deenqtt/project-test/render_final.png

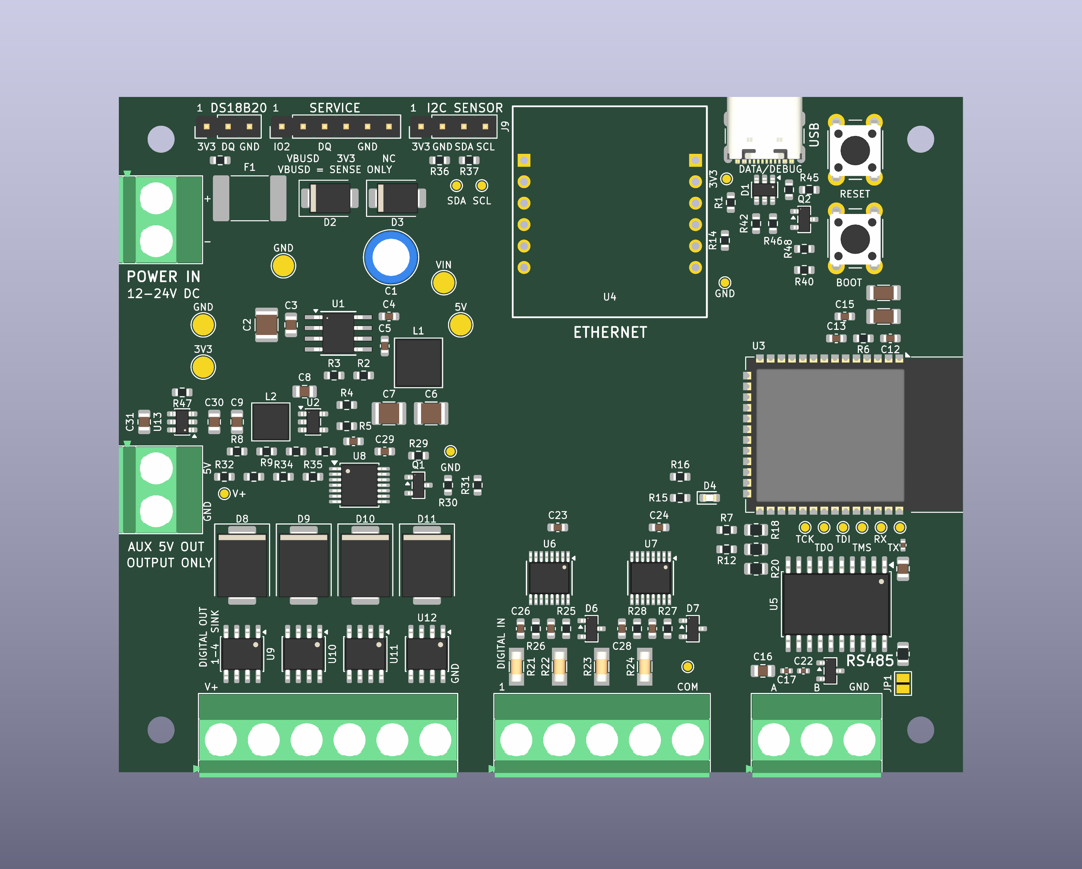
render_final.png
