deenqtt/project-test/docs/superpowers/plans/2026-09-14-phase5a-wiz850io.md

# Phase 5A WIZ850io Implementation Plan

> **For agentic workers:** REQUIRED SUB-SKILL: Use superpowers:executing-plans to implement this plan task-by-task.

**Goal:** Capture only the WIZ850io Ethernet module interface and verify its connectivity to the frozen ESP32-S3 GPIO nets.

**Architecture:** Add a dedicated hierarchical sheet using one custom 12-pin module symbol visually divided into official J1 and J2 1x6 headers. Connect it through global power and frozen Ethernet nets; retain existing MCU-side reset/select biases and add only carrier-side supply bypassing justified by the vendor module schematic.

**Tech Stack:** KiCad 9 schematic format, KiCad MCP, official WIZnet WIZ850io documentation and revision 1.1 schematic.

## Global Constraints

- Do not modify Phase 3 or Phase 4B electrical topology.
- Do not capture RS485, DI, DO, sensors, USB-C, or PCB layout.
- Do not guess module footprint geometry.
- Do not suppress ERC warnings without electrical justification.

---

### Task 1: Baseline and vendor verification

**Files:**
- Read: `hardware/kicad_mcp_test.kicad_sch`
- Read: `hardware/esp32_core.kicad_sch`

- [ ] Snapshot the project before changes.
- [ ] Verify supply range, J1/J2 pinout, SPI levels, reset timing, INT output type, and on-module bypass/damping from official WIZnet sources.
- [ ] Record any missing mechanical dimensions that prevent a production footprint.

### Task 2: Module library assets

**Files:**
- Create: `hardware/project_wiznet.kicad_sym`
- Prepare only if fully dimensioned: `hardware/Project_WIZnet.pretty/WIZ850io_Module_THT.kicad_mod`
- Modify: `hardware/sym-lib-table`

- [ ] Create one `WIZ850io` symbol with unique `J1.1`–`J1.6` and `J2.1`–`J2.6` pins.
- [ ] Mark J2.4 as no-connect and encode official pin electrical types.
- [ ] Leave the PCB footprint unresolved if drill/pin geometry is absent from the official drawing.

### Task 3: Ethernet hierarchical sheet

**Files:**
- Create: `hardware/ethernet_wiz850io.kicad_sch`
- Modify: `hardware/kicad_mcp_test.kicad_sch`

- [ ] Add `ETHERNET_WIZ850IO` hierarchical sheet.
- [ ] Place WIZ850io module, 10 uF and 100 nF carrier-side bypass capacitors, and 3V3/GND test points.
- [ ] Connect `3V3_LOGIC`, `LOGIC_GND`, and all six frozen Ethernet nets.
- [ ] Add orientation, pin-numbering, RJ45 edge, and mechanical verification notes.

### Task 4: Verification

**Files:**
- Verify: `hardware/kicad_mcp_test.kicad_sch`
- Verify: `hardware/ethernet_wiz850io.kicad_sch`

- [ ] Run structural validation through KiCad CLI.
- [ ] Run fresh ERC and compare its warning count with the Phase 4B baseline of 18.
- [ ] Confirm all six Ethernet nets connect U3 to the WIZ850io symbol.
- [ ] Check orphan wires, overlaps, off-grid geometry, frozen GPIO mapping, and startup-safe bias behavior.
- [ ] Save a final project snapshot and report unresolved mechanical dimensions.
