deenqtt/project-test/bcu_logic_gnd_only.png

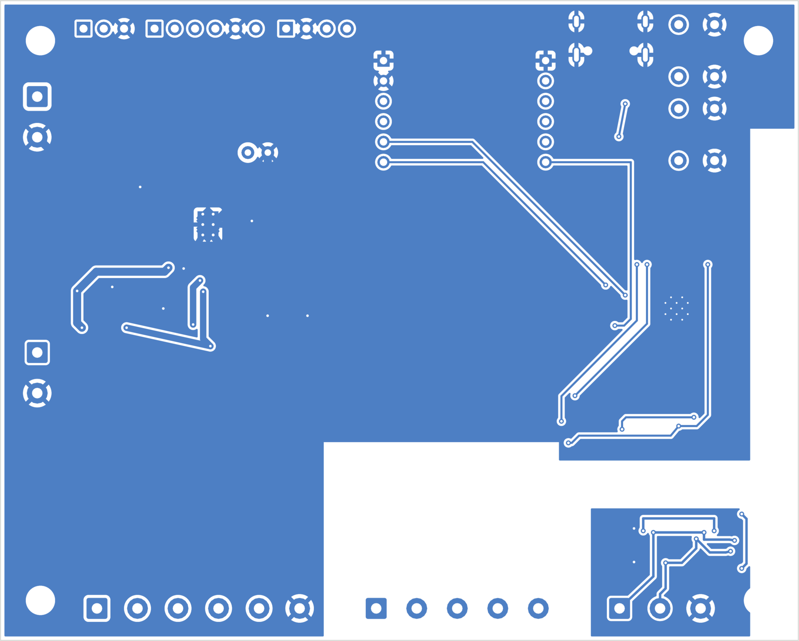
bcu_logic_gnd_only.png
