deenqtt/project-test/full.png

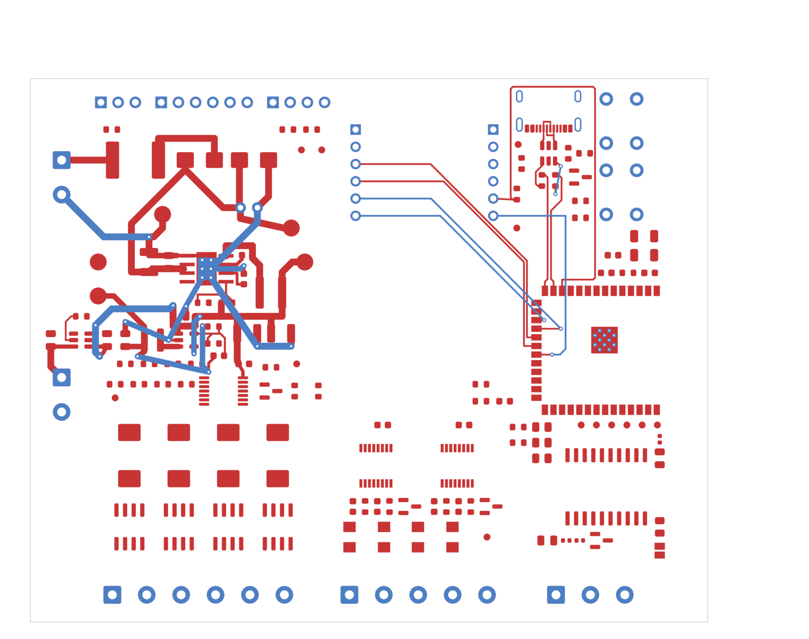
full.png
