deenqtt/project-test/full_board.png

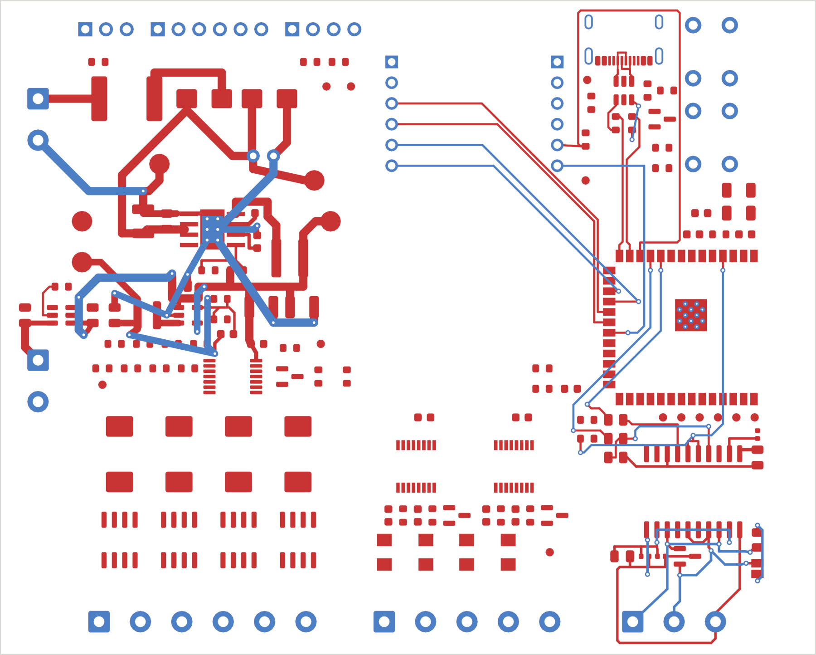
full_board.png
