deenqtt/project-test/j4_sm712_term_zoom.png

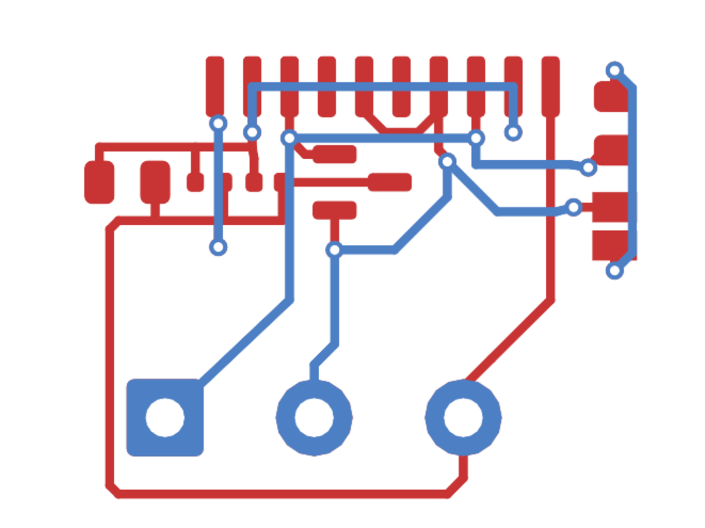
j4_sm712_term_zoom.png
