deenqtt/project-test/pwr_zoom.png

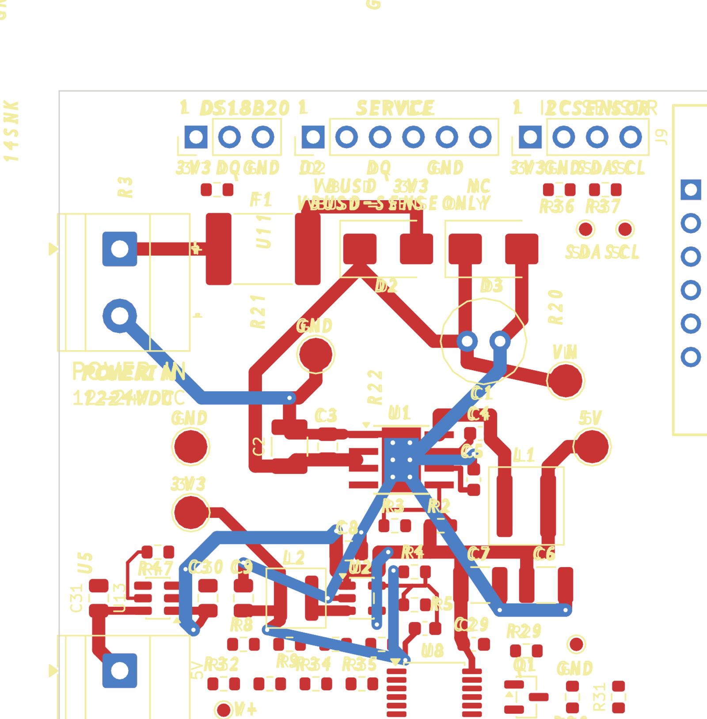
pwr_zoom.png
