deenqtt/project-test/rs485_subsystem_zoom.png

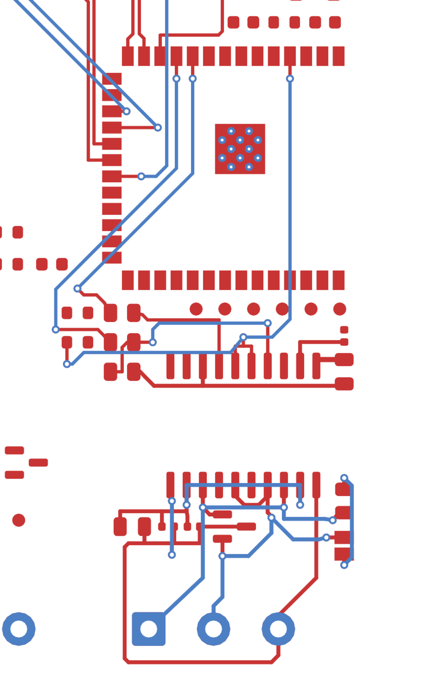
rs485_subsystem_zoom.png
