deenqtt/project-test/spi_zoom.png

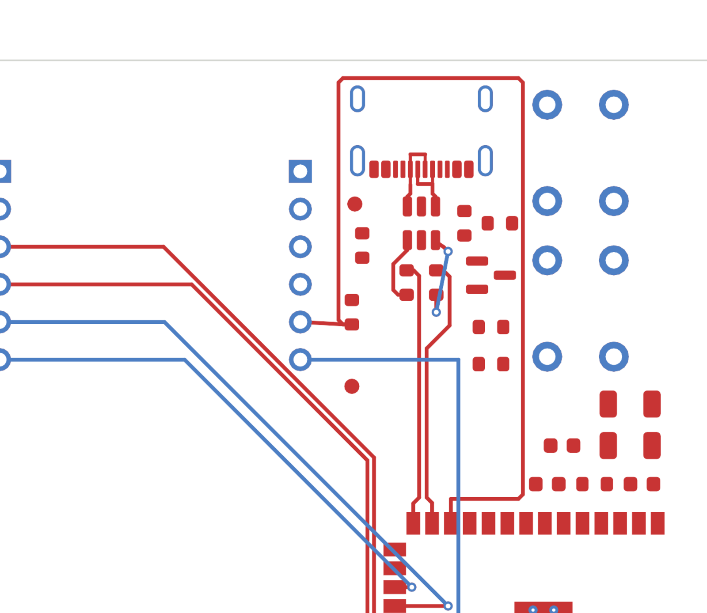
spi_zoom.png
