deenqtt/project-test/usb_zoom.png

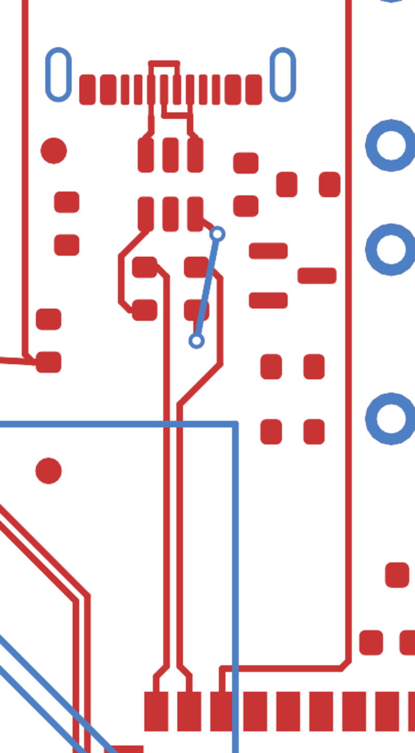
usb_zoom.png
