deenqtt/project-test/hardware/logs/PROMPT_step10_20260915_102520.md

Baseline before root schematic visual cleanup. Scope is root sheet layout only. No child-sheet edits, no component/value/wiring changes. Root validation passed; baseline flattened electrical design preserved.
