deenqtt/project-test/hardware/logs/PROMPT_step4B-0_20260914_120452.md

Create only ESP32-S3-WROOM-1-N8R2 core schematic per approved frozen Phase 4A GPIO map; preserve Phase 3A/3B and do not create peripheral circuits.
