deenqtt/project-test/hardware/logs/PROMPT_step4B_20260914_132249.md

PHASE 4B complete checkpoint: ESP32-S3-WROOM-1-N8R2 core only. Frozen GPIO map captured; 3V3_LOGIC decoupling; EN/reset and BOOT; native USB labels; safe-state bias for DO, RS485 direction, Ethernet CS/reset; status LED; UART0/JTAG test pads; no peripheral circuits and no PCB work. Fresh ERC: 0 errors, 18 intentional unconnected-global-label warnings for deferred peripheral nets.
