deenqtt/project-test/hardware/logs/PROMPT_step5A-0_20260914_133037.md

Before PHASE 5A WIZ850io Ethernet interface. Preserve Phase 3 and Phase 4B. Scope: WIZ850io only; no RS485, DI, DO, sensors, USB-C, or PCB layout.
