deenqtt/project-test/hardware/logs/PROMPT_step5A_20260914_134546.md

PHASE 5A complete: WIZ850io module-only Ethernet hierarchical schematic, official J1/J2 pinout, carrier bypass, frozen ESP32 nets, corrected module-aware startup bias (remove redundant CS 10k; reset pulldown 1k against onboard 4.7k), verified custom symbol and footprint from official WIZnet drawing and rev1.1 Altium PcbDoc. ERC 0 errors, 14 deferred non-Ethernet warnings. No PCB placement or other peripheral capture.
