deenqtt/project-test/hardware/logs/PROMPT_step6A-0_20260914_193911.md

Execute only Phase 6A: four-channel isolated 12–24 V digital inputs using two ISO1212DBQR devices; preserve existing Ethernet, RS485, GPIO mapping, and ground isolation.
