deenqtt/project-test/hardware/logs/PROMPT_step6A_20260914_194914.md

Completed Phase 6A only: four-channel isolated 12–24 V digital inputs using two ISO1212DBQR devices, 330R/562R/10nF networks, dual 33V TVS protection, Phoenix 1715750 connector, and verified DI_FIELD_GND isolation.
