deenqtt/project-test/hardware/logs/PROMPT_step6B-0_20260914_195740.md

Phase 6B pre-capture verification stopped because direct ESP32-S3 3.3 V drive does not provide a datasheet-guaranteed HIGH margin for ZXMS6005N8Q VIH(min)=3.0 V. No schematic capture performed.
