deenqtt/project-test/hardware/logs/PROMPT_step6B-R1-0_20260914_202226.md

Complete Phase 6B-R1 only using SN74AHCT125 level translation, hardware-default-disabled OE, four ZXMS6005N8Q protected low-side outputs, external flyback support, and strict ground-domain audit.
