deenqtt/project-test/hardware/logs/PROMPT_step9_20260915_101418.md

Phase 9 AUX_5V_OUTPUT: TPS2553DBVR, RILIM 105k 1%, CIN/COUT 1uF X7R 10V, EN tied to 5V_MAIN, FAULT explicit NC, Phoenix 1715721 output connector. Root ERC baseline 0 errors / 4 known warnings; flattened component count 130; no duplicate references.
