deenqtt/project-test/hardware/logs/PROMPT_step10_20260915_102925.md

Root layout cleanup was stopped after MCP sheet relocation test changed child instance annotation. Root and AUX were restored from verified Phase 9 snapshots. Final root ERC 0 errors / 4 known warnings; flattened netlist 130 components and 105 nets identical to Phase 9; no final layout change retained.
