deenqtt/project-test/hardware/logs/PROMPT_step9-0_20260915_100747.md

Phase 9 AUX_5V_OUTPUT approved capture baseline: TPS2553DBVR, RILIM 105k 1%, CIN/COUT 1uF, Phoenix 1715721.
