deenqtt/project-test/hardware/kicad_mcp_test_cli-drc.txt

** Drc report for kicad_mcp_test.kicad_pcb **
** Created on 2026-09-14T08:30:19+0700 **
** Report includes: Errors, Warnings **

** Found 0 DRC violations **

** Found 0 unconnected pads **

** Found 0 Footprint errors **

** End of Report **
