deenqtt/project-test/hardware/snapshots/hardware_snapshot_step10_root_layout_before_cleanup_20260915_102520/kicad_mcp_test.kicad_pcb

## KiCad design hardware/snapshots/hardware_snapshot_step10_root_layout_before_cleanup_20260915_102520/kicad_mcp_test.kicad_pcb (2026-09-25)

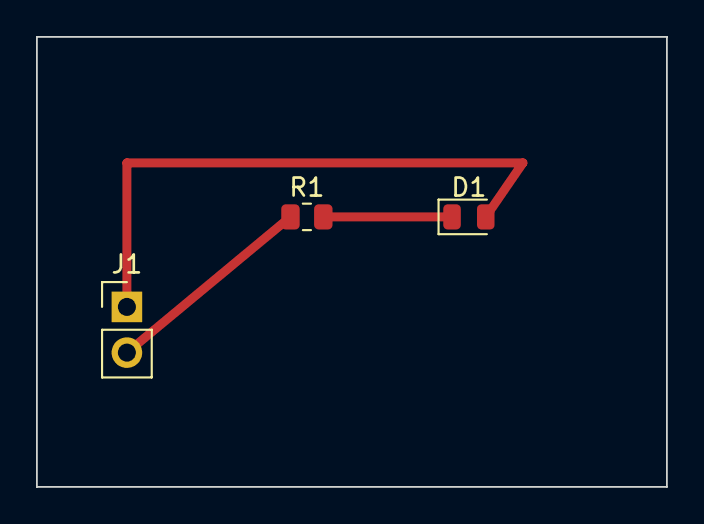
[picture p10: board hardware/snapshots/hardware_snapshot_step10_root_layout_before_cleanu… from above]

Board: 2 copper layers, 35.0 x 25.0 mm, 3 parts (0 on the bottom side), 3 nets.

Parts:
D1: LED; LED_0805_2012Metric
J1: INPUT; PinHeader_1x02_P2.54mm_Vertical
R1: 1k; R_0805_2012Metric

Connections:
unnamed: D1.1, R1.2
unnamed: D1.2, J1.1
unnamed: J1.2, R1.1
