deenqtt/project-test/hardware/kicad_mcp_test.kicad_pcb

## KiCad design hardware/kicad_mcp_test.kicad_pcb (2026-09-25)

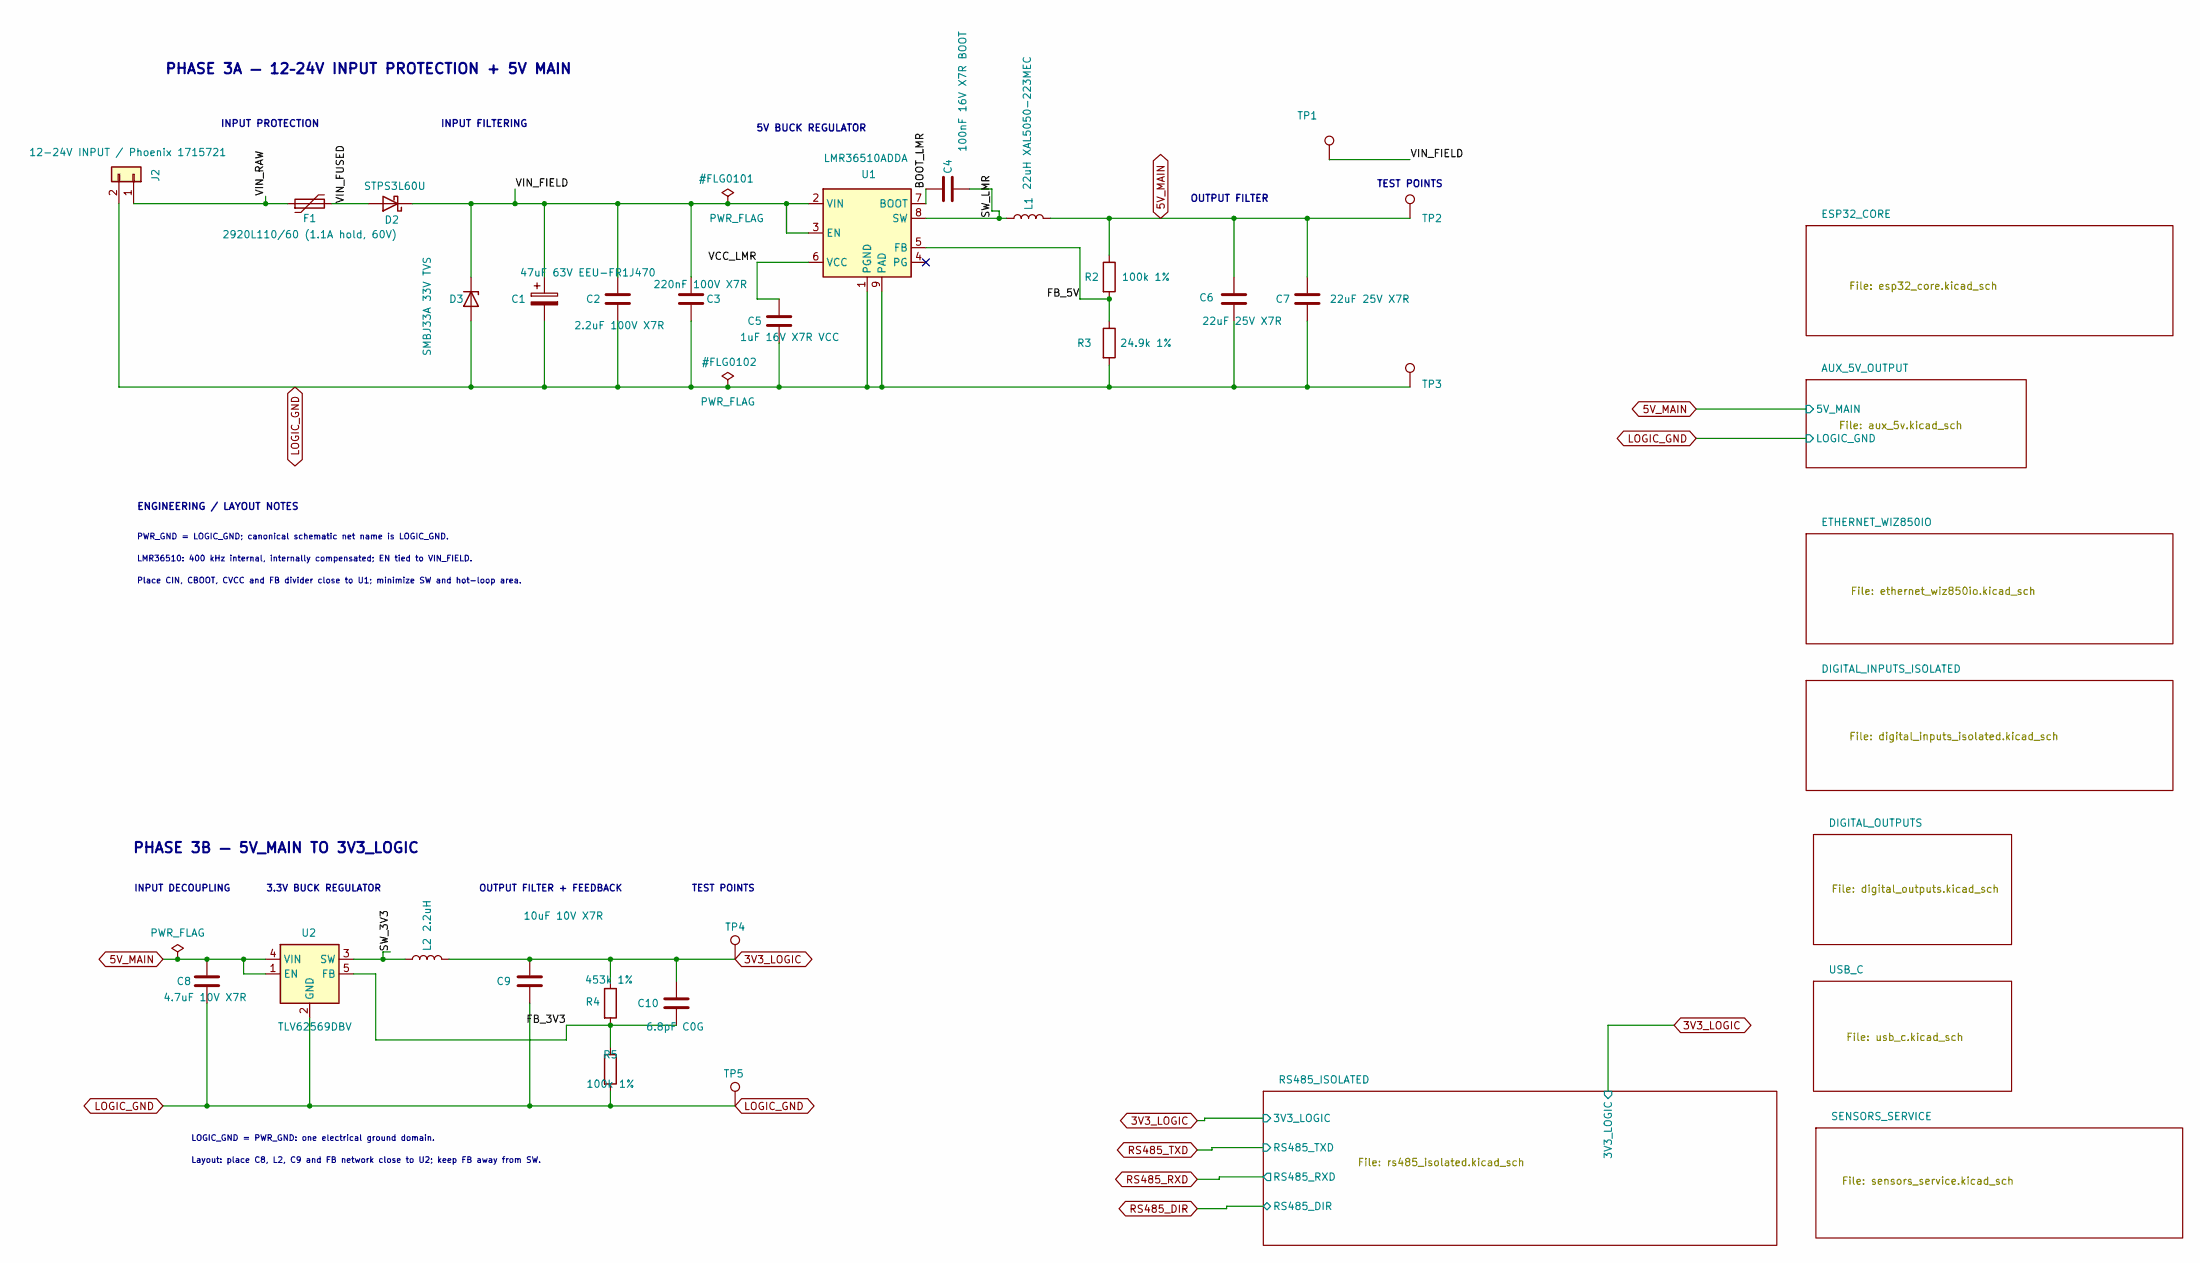
[picture p11: schematic kicad_mcp_test.kicad_sch]

Parts:
C1: 47uF 63V EEU-FR1J470; C_Radial_D6.3mm_H11.0mm_P2.50mm; MPN EEU-FR1J470
C2: 2.2uF 100V X7R; C_1210_3225Metric; Voltage 100V
C3: 220nF 100V X7R; C_0805_2012Metric; Voltage 100V
C4: 100nF 16V X7R BOOT; C_0603_1608Metric; Voltage 16V min
C5: 1uF 16V X7R VCC; C_0603_1608Metric; Voltage 16V
C6, C7: 22uF 25V X7R; C_1210_3225Metric; Voltage 25V
C8: 4.7uF 10V X7R; C_0805_2012Metric; Voltage 10V; MPN GRM21BR71A475KA73L
C9: 10uF 10V X7R; C_0805_2012Metric; Voltage 10V; MPN GRM21BR71A106KE51L
C10: 6.8pF C0G; C_0603_1608Metric; Voltage 50V
D2: STPS3L60U; D_SMB; MPN STPS3L60U
D3: SMBJ33A 33V TVS; D_SMB; MPN SMBJ33A
F1: 2920L110/60 (1.1A hold, 60V); Fuse_2920_7451Metric; MPN 2920L110/60MR
J2: 12-24V INPUT / Phoenix 1715721; TerminalBlock_Phoenix_MKDS-1,5-2-5.08_1x02_P5.08mm_Horizont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; MPN 1715721
L1: 22uH XAL5050-223MEC; L_Coilcraft_XAL5050-XXX; MPN XAL5050-223MEC
L2: 2.2uH; L_Coilcraft_XAL4020-XXX; MPN XAL4020-222MEC
R2: 100k 1%; R_0603_1608Metric; Tolerance 1%
R3: 24.9k 1%; R_0603_1608Metric; Tolerance 1%
R4: 453k 1%; R_0603_1608Metric
R5: 100k 1%; R_0603_1608Metric
TP1: VIN_FIELD; TestPoint_Pad_D2.5mm
TP2: 5V_MAIN; TestPoint_Pad_D2.5mm
TP3: PWR_GND; TestPoint_Pad_D2.5mm
TP4: 3V3_LOGIC; TestPoint_Pad_D2.5mm
TP5: LOGIC_GND; TestPoint_Pad_D2.5mm
U1: LMR36510ADDA; Texas_HTSOP-8-1EP_3.9x4.9mm_P1.27mm_EP2.95x4.9mm_Mask2.4x3.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; MPN LMR36510ADDA
U2: TLV62569DBV; SOT-23-5; MPN TLV62569DBV

Connections:
3V3_LOGIC: C9.1, C10.1, L2.2, R4.1, TP4.1; also elsewhere on the board
5V_MAIN: C6.1, C7.1, C8.1, L1.2, R2.1, TP2.1, U2.1 (EN), U2.4 (VIN); also elsewhere on the board
/BOOT_LMR: C4.1, U1.7 (BOOT)
/FB_3V3: C10.2, R4.2, R5.1, U2.5 (FB)
/FB_5V: R2.2, R3.1, U1.5 (FB)
/SW_3V3: L2.1, U2.3 (SW)
/SW_LMR: C4.2, L1.1, U1.8 (SW)
/VCC_LMR: C5.1, U1.6 (VCC)
/VIN_FIELD: C1.1, C2.1, C3.1, D2.1 (K), D3.1 (K), TP1.1, U1.2 (VIN), U1.3 (EN)
/VIN_FUSED: D2.2 (A), F1.2
/VIN_RAW: F1.1, J2.1
LOGIC_GND: C1.2, C2.2, C3.2, C5.2, C6.2, C7.2, C8.2, C9.2, D3.2 (A), J2.2, R3.2, R5.2, TP3.1, TP5.1, U1.1 (PGND), U1.9 (PAD), U2.2 (GND); also elsewhere on the board

Notes on the sheet:
TEST POINTS
LMR36510: 400 kHz internal, internally compensated; EN tied to VIN_FIELD.
INPUT FILTERING
ENGINEERING / LAYOUT NOTES
LOGIC_GND = PWR_GND: one electrical ground domain.
5V BUCK REGULATOR
PHASE 3A — 12–24V INPUT PROTECTION + 5V MAIN
PHASE 3B — 5V_MAIN TO 3V3_LOGIC
3.3V BUCK REGULATOR
INPUT PROTECTION
OUTPUT FILTER
OUTPUT FILTER + FEEDBACK
Place CIN, CBOOT, CVCC and FB divider close to U1; minimize SW and hot-loop area.
INPUT DECOUPLING
PWR_GND = LOGIC_GND; canonical schematic net name is LOGIC_GND.
Layout: place C8, L2, C9 and FB network close to U2; keep FB away from SW.

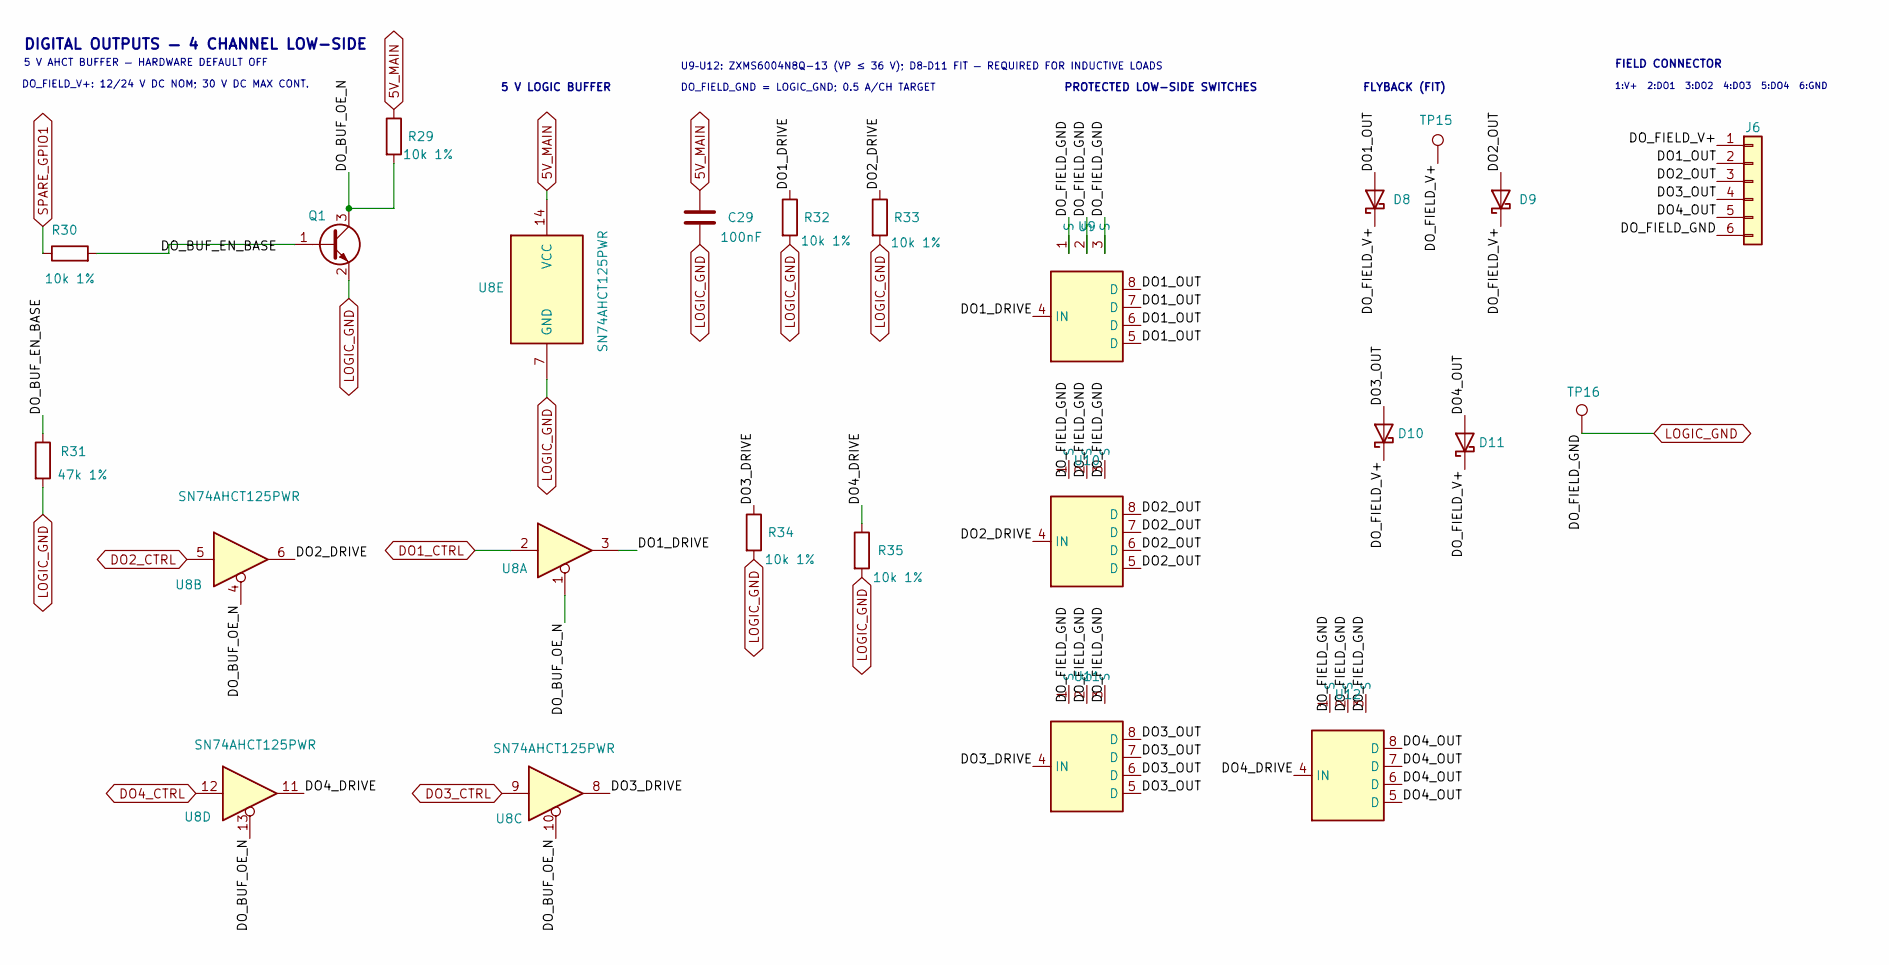
[picture p12: schematic digital_outputs.kicad_sch]

Parts:
C29: 100nF; C_0603_1608Metric; Voltage 16V
D8, D9, D10, D11: B360Q-13-F; D_SMC; MPN B360Q-13-F
J6: Phoenix 1706303; TerminalBlock_Phoenix_MKDS-1,5-6-5.08_1x06_P5.08mm_Horizont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; MPN 1706303
Q1: MMBT3904-7-F; SOT-23; MPN MMBT3904-7-F
R29, R30, R32, R33, R34, R35: 10k 1%; R_0603_1608Metric
R31: 47k 1%; R_0603_1608Metric
TP15: DO_FIELD_V+; TestPoint_Pad_D1.0mm
TP16: DO_FIELD_GND; TestPoint_Pad_D1.0mm
U8: SN74AHCT125PWR; TSSOP-14_4.4x5mm_P0.65mm
U9, U10, U11, U12: ZXMS6004N8Q-13; SOIC-8_3.9x4.9mm_P1.27mm; MPN ZXMS6004N8Q-13

Connections:
5V_MAIN: C29.1, R29.1, U8.14 (VCC); also elsewhere on the board
/DIGITAL_OUTPUTS/DO1_DRIVE: R32.1, U8.3, U9.4 (IN)
/DIGITAL_OUTPUTS/DO1_OUT: D8.2 (A), J6.2, U9.5 (D), U9.6 (D), U9.7 (D), U9.8 (D)
/DIGITAL_OUTPUTS/DO2_DRIVE: R33.1, U8.6, U10.4 (IN)
/DIGITAL_OUTPUTS/DO2_OUT: D9.2 (A), J6.3, U10.5 (D), U10.6 (D), U10.7 (D), U10.8 (D)
/DIGITAL_OUTPUTS/DO3_DRIVE: R34.1, U8.8, U11.4 (IN)
/DIGITAL_OUTPUTS/DO3_OUT: D10.2 (A), J6.4, U11.5 (D), U11.6 (D), U11.7 (D), U11.8 (D)
/DIGITAL_OUTPUTS/DO4_DRIVE: R35.1, U8.11, U12.4 (IN)
/DIGITAL_OUTPUTS/DO4_OUT: D11.2 (A), J6.5, U12.5 (D), U12.6 (D), U12.7 (D), U12.8 (D)
/DIGITAL_OUTPUTS/DO_BUF_EN_BASE: Q1.1 (B), R30.2, R31.1
/DIGITAL_OUTPUTS/DO_BUF_OE_N: Q1.3 (C), R29.2, U8.1, U8.4, U8.10, U8.13
/DIGITAL_OUTPUTS/DO_FIELD_V+: D8.1 (K), D9.1 (K), D10.1 (K), D11.1 (K), J6.1, TP15.1
DO1_CTRL: U8.2; also elsewhere on the board
DO2_CTRL: U8.5; also elsewhere on the board
DO3_CTRL: U8.9; also elsewhere on the board
DO4_CTRL: U8.12; also elsewhere on the board
LOGIC_GND: C29.2, J6.6, Q1.2 (E), R31.2, R32.2, R33.2, R34.2, R35.2, TP16.1, U8.7 (GND), U9.1 (S), U9.2 (S), U9.3 (S), U10.1 (S), U10.2 (S), U10.3 (S), U11.1 (S), U11.2 (S), U11.3 (S), U12.1 (S), U12.2 (S), U12.3 (S); also elsewhere on the board
SPARE_GPIO1: R30.1; also elsewhere on the board

Notes on the sheet:
U9–U12: ZXMS6004N8Q-13 (VP ≤ 36 V); D8–D11 FIT — REQUIRED FOR INDUCTIVE LOADS
5 V AHCT BUFFER — HARDWARE DEFAULT OFF
FLYBACK (FIT)
5 V LOGIC BUFFER
PROTECTED LOW-SIDE SWITCHES
1:V+ 2:DO1 3:DO2 4:DO3 5:DO4 6:GND
DO_FIELD_GND = LOGIC_GND; 0.5 A/CH TARGET
DIGITAL OUTPUTS — 4 CHANNEL LOW-SIDE
FIELD CONNECTOR
DO_FIELD_V+: 12/24 V DC NOM; 30 V DC MAX CONT.

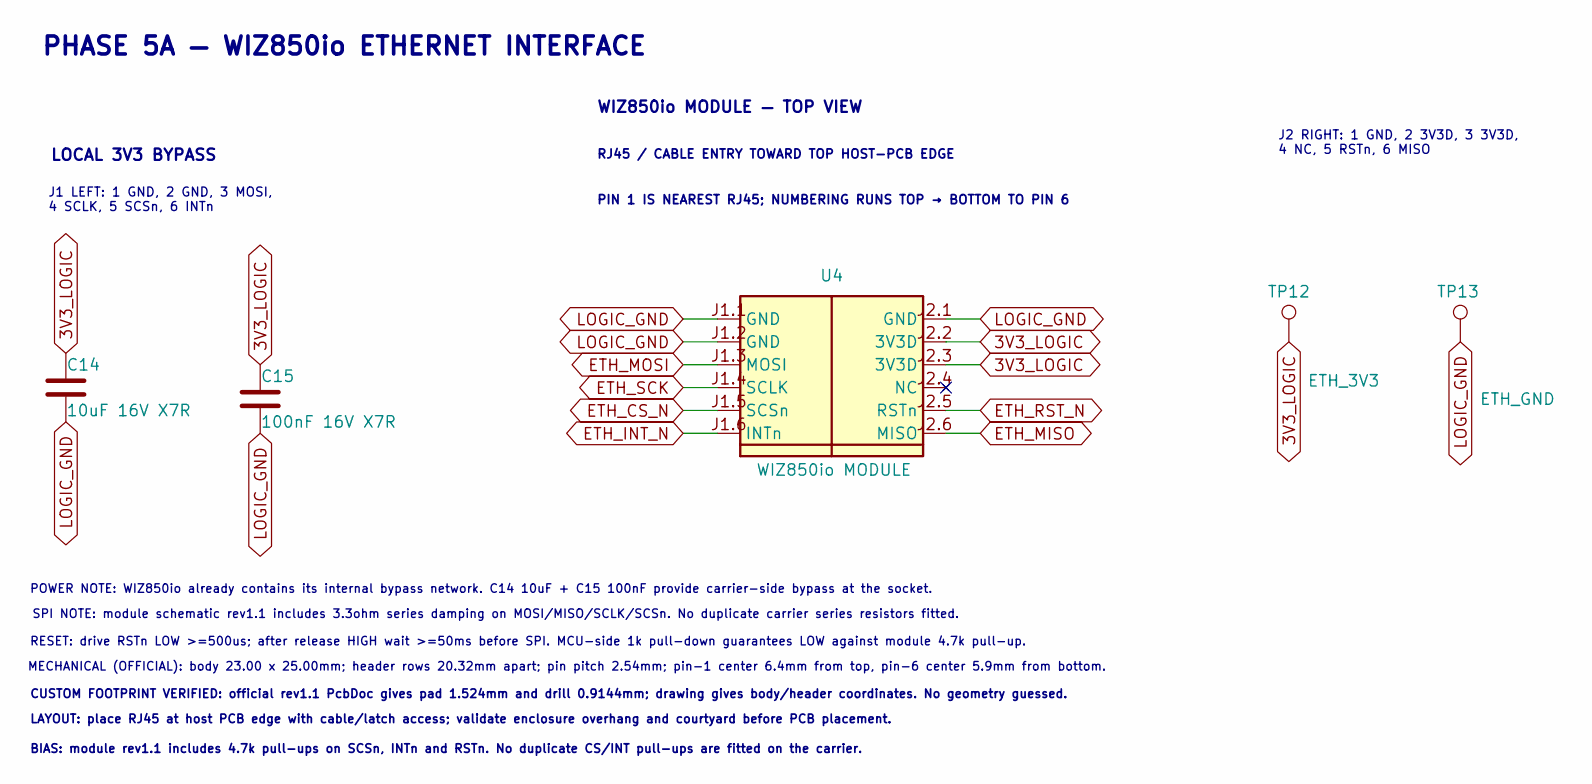
[picture p13: schematic ethernet_wiz850io.kicad_sch]

Parts:
C14: 10uF 16V X7R; C_1206_3216Metric; Voltage 16V
C15: 100nF 16V X7R; C_0603_1608Metric; Voltage 16V
TP12: ETH_3V3; TestPoint_Pad_D1.0mm
TP13: ETH_GND; TestPoint_Pad_D1.0mm
U4: WIZ850io MODULE; WIZ850io_Module_THT; MPN WIZ850io

Connections:
3V3_LOGIC: C14.1, C15.1, TP12.1, U4.J2.2 (3V3D), U4.J2.3 (3V3D); also elsewhere on the board
ETH_CS_N: U4.J1.5 (SCSn); also elsewhere on the board
ETH_INT_N: U4.J1.6 (INTn); also elsewhere on the board
ETH_MISO: U4.J2.6 (MISO); also elsewhere on the board
ETH_MOSI: U4.J1.3 (MOSI); also elsewhere on the board
ETH_RST_N: U4.J2.5 (RSTn); also elsewhere on the board
ETH_SCK: U4.J1.4 (SCLK); also elsewhere on the board
LOGIC_GND: C14.2, C15.2, TP13.1, U4.J1.1 (GND), U4.J1.2 (GND), U4.J2.1 (GND); also elsewhere on the board

Notes on the sheet:
MECHANICAL (OFFICIAL): body 23.00 x 25.00mm; header rows 20.32mm apart; pin pitch 2.54mm; pin-1 center 6.4mm from top, pin-6 center 5.9mm from bottom.
RJ45 / CABLE ENTRY TOWARD TOP HOST-PCB EDGE
LOCAL 3V3 BYPASS
CUSTOM FOOTPRINT VERIFIED: official rev1.1 PcbDoc gives pad 1.524mm and drill 0.9144mm; drawing gives body/header coordinates. No geometry guessed.
BIAS: module rev1.1 includes 4.7k pull-ups on SCSn, INTn and RSTn. No duplicate CS/INT pull-ups are fitted on the carrier.
J1 LEFT: 1 GND, 2 GND, 3 MOSI, 4 SCLK, 5 SCSn, 6 INTn
PHASE 5A — WIZ850io ETHERNET INTERFACE
POWER NOTE: WIZ850io already contains its internal bypass network. C14 10uF + C15 100nF provide carrier-side bypass at the socket.
J2 RIGHT: 1 GND, 2 3V3D, 3 3V3D, 4 NC, 5 RSTn, 6 MISO
PIN 1 IS NEAREST RJ45; NUMBERING RUNS TOP → BOTTOM TO PIN 6
RESET: drive RSTn LOW >=500us; after release HIGH wait >=50ms before SPI. MCU-side 1k pull-down guarantees LOW against module 4.7k pull-up.
WIZ850io MODULE — TOP VIEW
SPI NOTE: module schematic rev1.1 includes 3.3ohm series damping on MOSI/MISO/SCLK/SCSn. No duplicate carrier series resistors fitted.
LAYOUT: place RJ45 at host PCB edge with cable/latch access; validate enclosure overhang and courtyard before PCB placement.

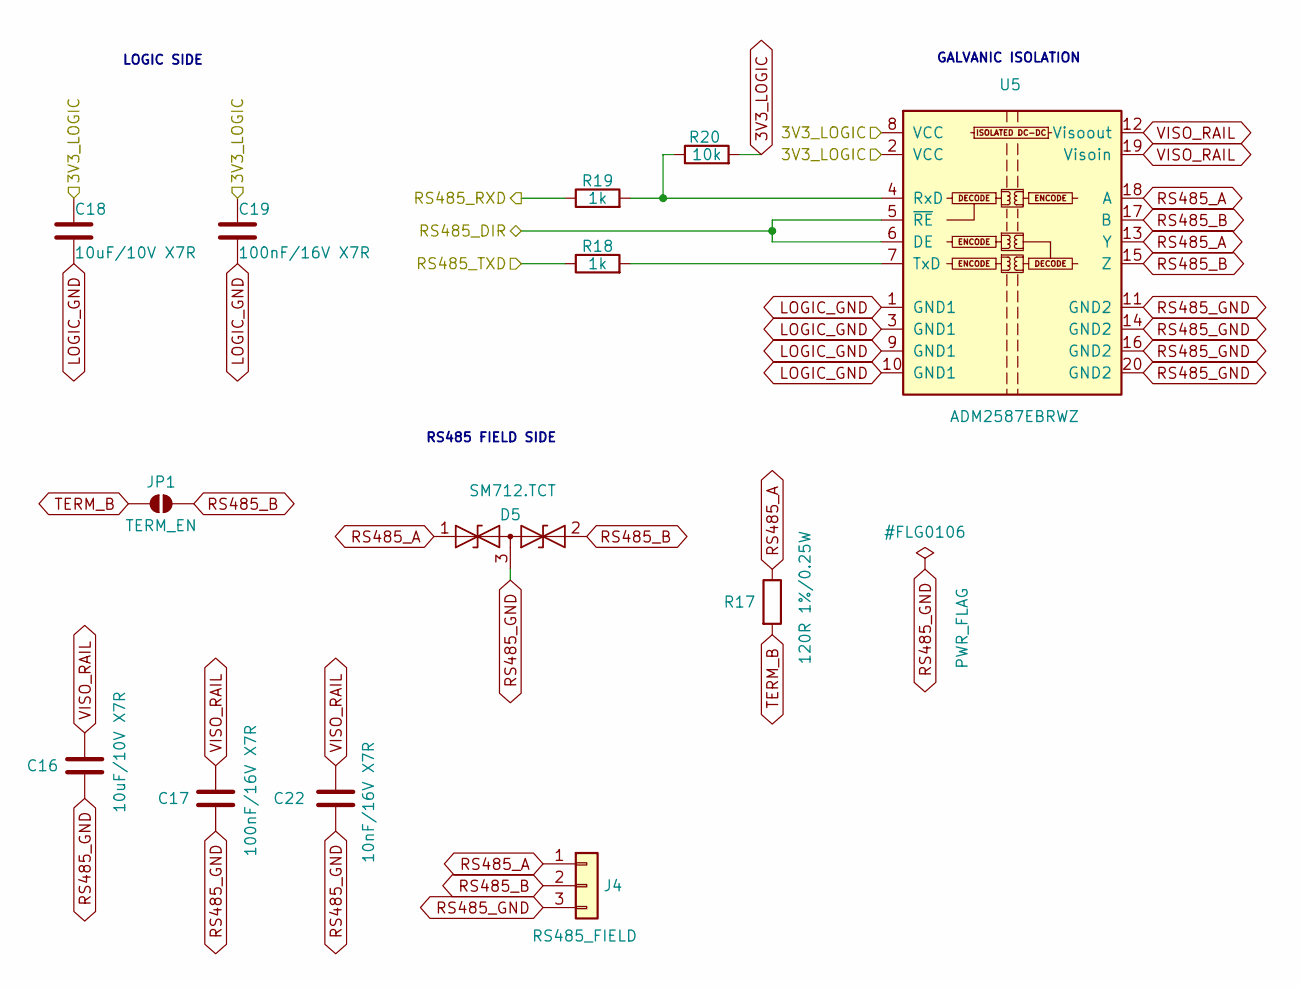
[picture p14: schematic rs485_isolated.kicad_sch]

Parts:
C16, C18: 10uF/10V X7R; C_0805_2012Metric; MPN GRM21BR71A106KE51K
C17, C19: 100nF/16V X7R; C_0402_1005Metric; MPN GRM21BR71H104KA01L
C22: 10nF/16V X7R; C_0402_1005Metric; MPN GRM21BR71H104KA01L
D5: SM712.TCT; SOT-23; MPN SM712.TCT
J4: RS485_FIELD; TerminalBlock_Phoenix_MKDS-1,5-3-5.08_1x03_P5.08mm_Horizont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; MPN 1715734
JP1: TERM_EN; SolderJumper-2_P1.3mm_Open_Pad1.0x1.5mm
R17: 120R 1%/0.25W; R_0805_2012Metric
R18, R19: 1k; R_0805_2012Metric
R20: 10k; R_0805_2012Metric
U5: ADM2587EBRWZ; SOIC-20W_7.5x12.8mm_P1.27mm; MPN ADM2587EBRWZ

Connections:
3V3_LOGIC: C18.1, C19.1, R20.2, U5.2 (VCC), U5.8 (VCC); also elsewhere on the board
LOGIC_GND: C18.2, C19.2, U5.1 (GND1), U5.3 (GND1), U5.9 (GND1), U5.10 (GND1); also elsewhere on the board
unnamed: R19.2, R20.1, U5.4 (RxD)
unnamed: R18.2, U5.7 (TxD)
RS485_A: D5.1 (A1), J4.1, R17.1, U5.13 (Y), U5.18 (A)
RS485_B: D5.2 (A2), J4.2, JP1.2 (B), U5.15 (Z), U5.17 (B)
RS485_DIR: U5.5 (~RE), U5.6 (DE); also elsewhere on the board
RS485_GND: C16.2, C17.2, C22.2, D5.3 (common), J4.3, U5.11 (GND2), U5.14 (GND2), U5.16 (GND2), U5.20 (GND2)
RS485_RXD: R19.1; also elsewhere on the board
RS485_TXD: R18.1; also elsewhere on the board
TERM_B: JP1.1 (A), R17.2
VISO_RAIL: C16.1, C17.1, C22.1, U5.12 (Visoout), U5.19 (Visoin)

Notes on the sheet:
LOGIC SIDE
RS485 FIELD SIDE
GALVANIC ISOLATION

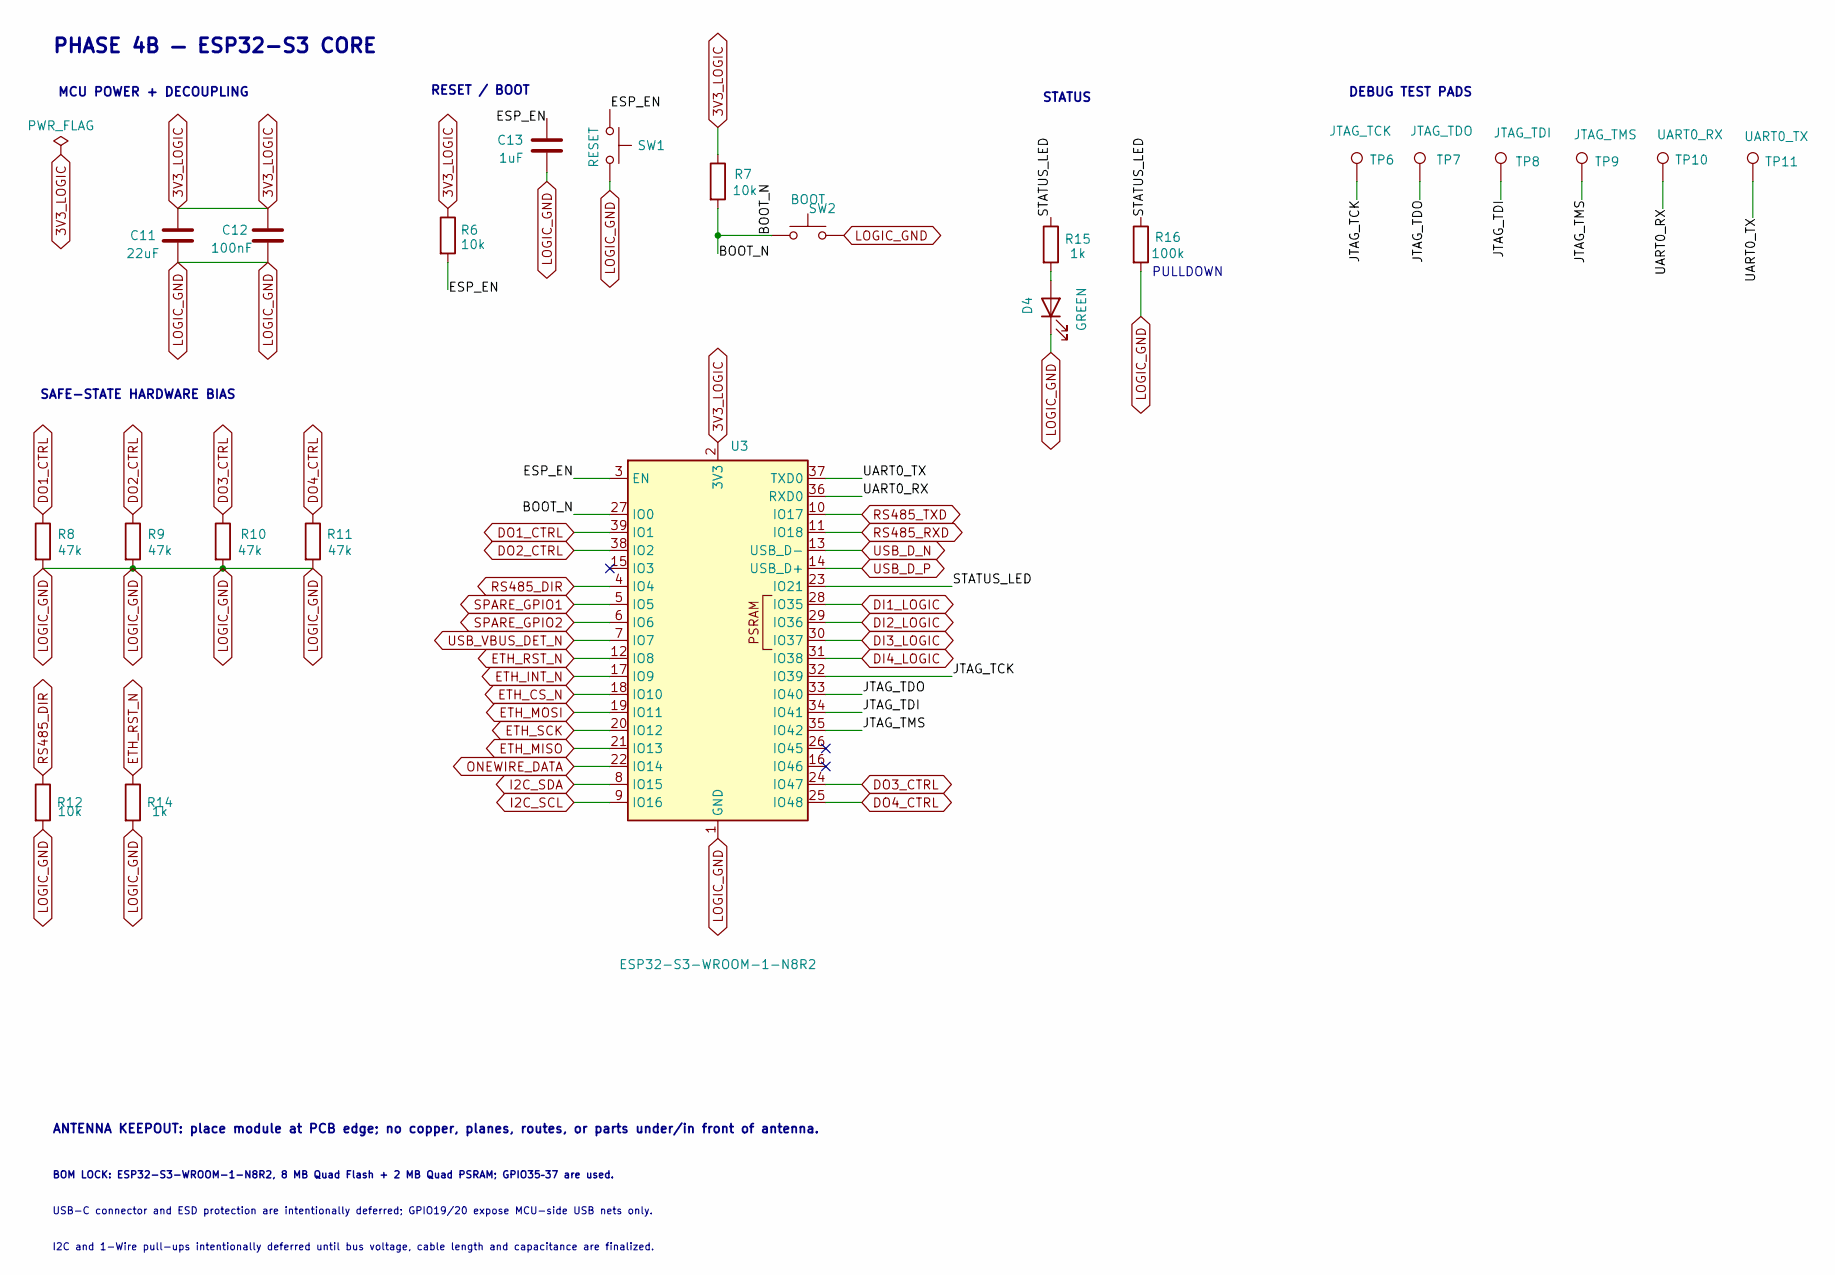
[picture p15: schematic esp32_core.kicad_sch]

Parts:
C11: 22uF; C_1206_3216Metric; Voltage 10 V
C12: 100nF; C_0603_1608Metric; Voltage 10 V
C13: 1uF; C_0603_1608Metric; Voltage 10 V
D4: GREEN; LED_0603_1608Metric; MPN LTST-C190KGKT
R6, R7, R12: 10k; R_0603_1608Metric
R8, R9, R10, R11: 47k; R_0603_1608Metric
R14, R15: 1k; R_0603_1608Metric
R16: 100k; R_0603_1608Metric
SW1: RESET; SW_PUSH_6mm; MPN B3F-1000
SW2: BOOT; SW_PUSH_6mm; MPN B3F-1000
TP6: JTAG_TCK; TestPoint_Pad_D1.0mm
TP7: JTAG_TDO; TestPoint_Pad_D1.0mm
TP8: JTAG_TDI; TestPoint_Pad_D1.0mm
TP9: JTAG_TMS; TestPoint_Pad_D1.0mm
TP10: UART0_RX; TestPoint_Pad_D1.0mm
TP11: UART0_TX; TestPoint_Pad_D1.0mm
U3: ESP32-S3-WROOM-1-N8R2; ESP32-S3-WROOM-1; MPN ESP32-S3-WROOM-1-N8R2

Connections:
3V3_LOGIC: C11.1, C12.1, R6.1, R7.1, U3.2 (3V3); also elsewhere on the board
/ESP32_CORE/BOOT_N: R7.2, SW2.1, U3.27 (IO0)
/ESP32_CORE/ESP_EN: C13.1, R6.2, SW1.1, U3.3 (EN)
/ESP32_CORE/JTAG_TCK: TP6.1, U3.32 (IO39)
/ESP32_CORE/JTAG_TDI: TP8.1, U3.34 (IO41)
/ESP32_CORE/JTAG_TDO: TP7.1, U3.33 (IO40)
/ESP32_CORE/JTAG_TMS: TP9.1, U3.35 (IO42)
/ESP32_CORE/STATUS_LED: R15.1, R16.1, U3.23 (IO21)
/ESP32_CORE/UART0_RX: TP10.1, U3.36 (RXD0)
/ESP32_CORE/UART0_TX: TP11.1, U3.37 (TXD0)
DI1_LOGIC: U3.28 (IO35); also elsewhere on the board
DI2_LOGIC: U3.29 (IO36); also elsewhere on the board
DI3_LOGIC: U3.30 (IO37); also elsewhere on the board
DI4_LOGIC: U3.31 (IO38); also elsewhere on the board
DO1_CTRL: R8.1, U3.39 (IO1); also elsewhere on the board
DO2_CTRL: R9.1, U3.38 (IO2); also elsewhere on the board
DO3_CTRL: R10.1, U3.24 (IO47); also elsewhere on the board
DO4_CTRL: R11.1, U3.25 (IO48); also elsewhere on the board
ETH_CS_N: U3.18 (IO10); also elsewhere on the board
ETH_INT_N: U3.17 (IO9); also elsewhere on the board
ETH_MISO: U3.21 (IO13); also elsewhere on the board
ETH_MOSI: U3.19 (IO11); also elsewhere on the board
ETH_RST_N: R14.1, U3.12 (IO8); also elsewhere on the board
ETH_SCK: U3.20 (IO12); also elsewhere on the board
I2C_SCL: U3.9 (IO16); also elsewhere on the board
I2C_SDA: U3.8 (IO15); also elsewhere on the board
LOGIC_GND: C11.2, C12.2, C13.2, D4.1 (K), R8.2, R9.2, R10.2, R11.2, R12.2, R14.2, R16.2, SW1.2, SW2.2, U3.1 (GND), U3.40 (GND), U3.41 (GND); also elsewhere on the board
unnamed: D4.2 (A), R15.2
ONEWIRE_DATA: U3.22 (IO14); also elsewhere on the board
RS485_DIR: R12.1, U3.4 (IO4); also elsewhere on the board
RS485_RXD: U3.11 (IO18); also elsewhere on the board
RS485_TXD: U3.10 (IO17); also elsewhere on the board
SPARE_GPIO1: U3.5 (IO5); also elsewhere on the board
SPARE_GPIO2: U3.6 (IO6); also elsewhere on the board
USB_D_N: U3.13 (USB_D-); also elsewhere on the board
USB_D_P: U3.14 (USB_D+); also elsewhere on the board
USB_VBUS_DET_N: U3.7 (IO7); also elsewhere on the board

Notes on the sheet:
MCU POWER + DECOUPLING
DEBUG TEST PADS
PULLDOWN
SAFE-STATE HARDWARE BIAS
STATUS
PHASE 4B — ESP32-S3 CORE
ANTENNA KEEPOUT: place module at PCB edge; no copper, planes, routes, or parts under/in front of antenna.
I2C and 1-Wire pull-ups intentionally deferred until bus voltage, cable length and capacitance are finalized.
USB-C connector and ESD protection are intentionally deferred; GPIO19/20 expose MCU-side USB nets only.
BOM LOCK: ESP32-S3-WROOM-1-N8R2, 8 MB Quad Flash + 2 MB Quad PSRAM; GPIO35–37 are used.
RESET / BOOT

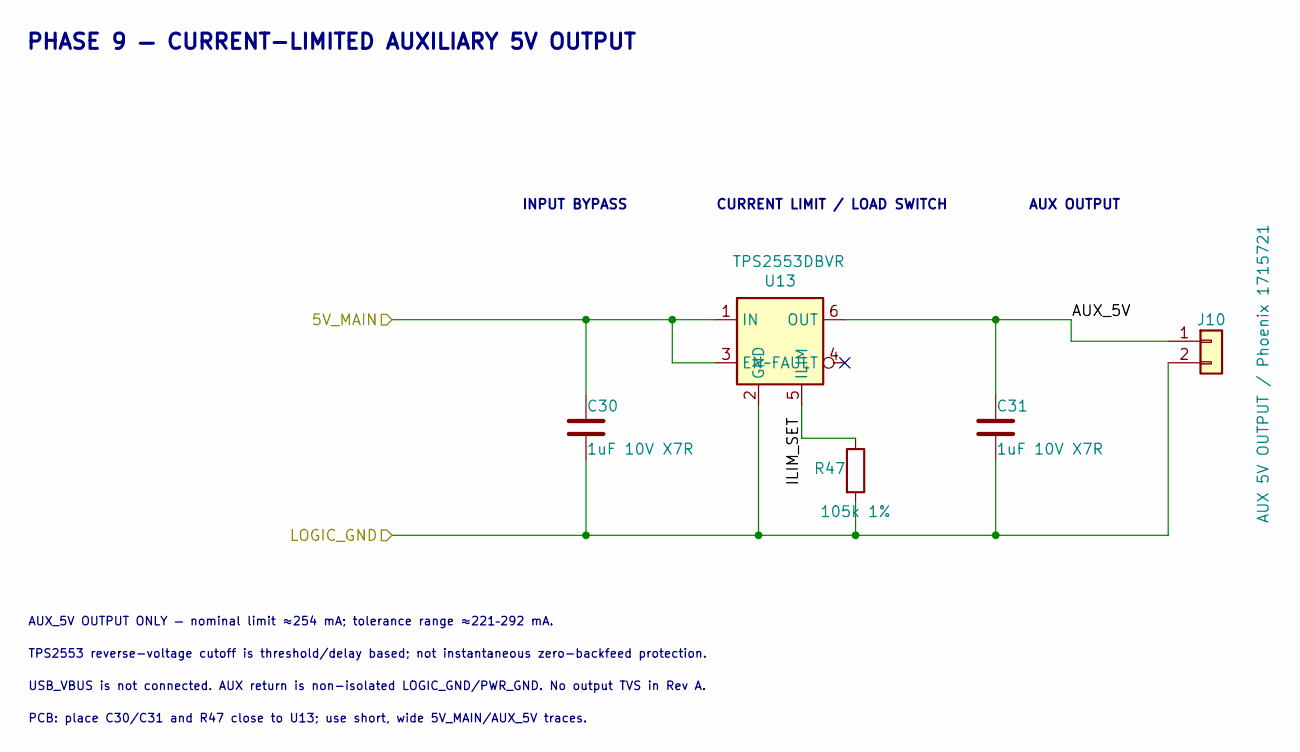
[picture p16: schematic aux_5v.kicad_sch]

Parts:
C30, C31: 1uF 10V X7R; C_0805_2012Metric; Voltage 10V
J10: AUX 5V OUTPUT / Phoenix 1715721; TerminalBlock_Phoenix_MKDS-1,5-2-5.08_1x02_P5.08mm_Horizont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; MPN 1715721
R47: 105k 1%; R_0603_1608Metric; Tolerance 1%
U13: TPS2553DBVR; SOT-23-6; MPN TPS2553DBVR

Connections:
5V_MAIN: C30.1, U13.1 (IN), U13.3 (EN); also elsewhere on the board
/AUX_5V_OUTPUT/AUX_5V: C31.1, J10.1, U13.6 (OUT)
/AUX_5V_OUTPUT/ILIM_SET: R47.1, U13.5 (ILIM)
LOGIC_GND: C30.2, C31.2, J10.2, R47.2, U13.2 (GND); also elsewhere on the board

Notes on the sheet:
PCB: place C30/C31 and R47 close to U13; use short, wide 5V_MAIN/AUX_5V traces.
INPUT BYPASS
AUX_5V OUTPUT ONLY — nominal limit ≈254 mA; tolerance range ≈221–292 mA.
PHASE 9 — CURRENT-LIMITED AUXILIARY 5V OUTPUT
USB_VBUS is not connected. AUX return is non-isolated LOGIC_GND/PWR_GND. No output TVS in Rev A.
TPS2553 reverse-voltage cutoff is threshold/delay based; not instantaneous zero-backfeed protection.
CURRENT LIMIT / LOAD SWITCH
AUX OUTPUT

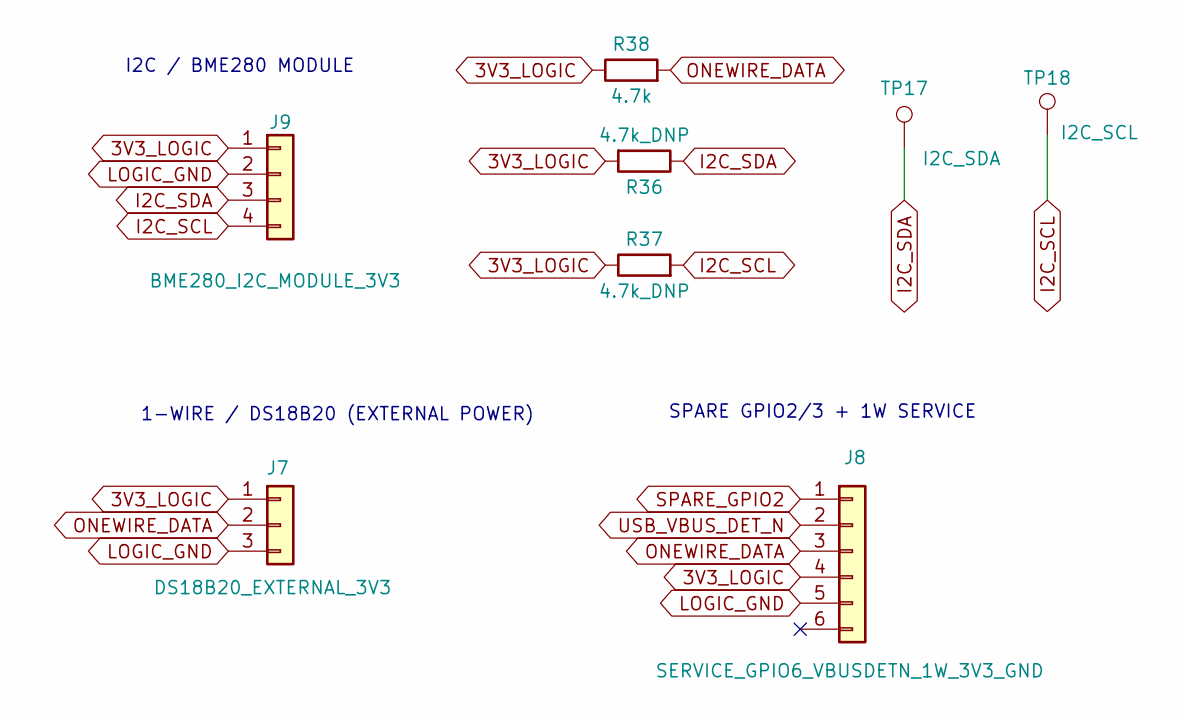
[picture p17: schematic sensors_service.kicad_sch]

Parts:
J7: DS18B20_EXTERNAL_3V3; PinHeader_1x03_P2.54mm_Vertical
J8: SERVICE_GPIO6_VBUSDETN_1W_3V3_GND; PinHeader_1x06_P2.54mm_Vertical
J9: BME280_I2C_MODULE_3V3; PinHeader_1x04_P2.54mm_Vertical
R36, R37: 4.7k_DNP; R_0603_1608Metric
R38: 4.7k; R_0603_1608Metric
TP17: I2C_SDA; TestPoint_Pad_D1.0mm
TP18: I2C_SCL; TestPoint_Pad_D1.0mm

Connections:
3V3_LOGIC: J7.1, J8.4, J9.1, R36.2, R37.1, R38.1; also elsewhere on the board
I2C_SCL: J9.4, R37.2, TP18.1; also elsewhere on the board
I2C_SDA: J9.3, R36.1, TP17.1; also elsewhere on the board
LOGIC_GND: J7.3, J8.5, J9.2; also elsewhere on the board
ONEWIRE_DATA: J7.2, J8.3, R38.2; also elsewhere on the board
SPARE_GPIO2: J8.1; also elsewhere on the board
USB_VBUS_DET_N: J8.2; also elsewhere on the board

Notes on the sheet:
I2C / BME280 MODULE
1-WIRE / DS18B20 (EXTERNAL POWER)
SPARE GPIO2/3 + 1W SERVICE

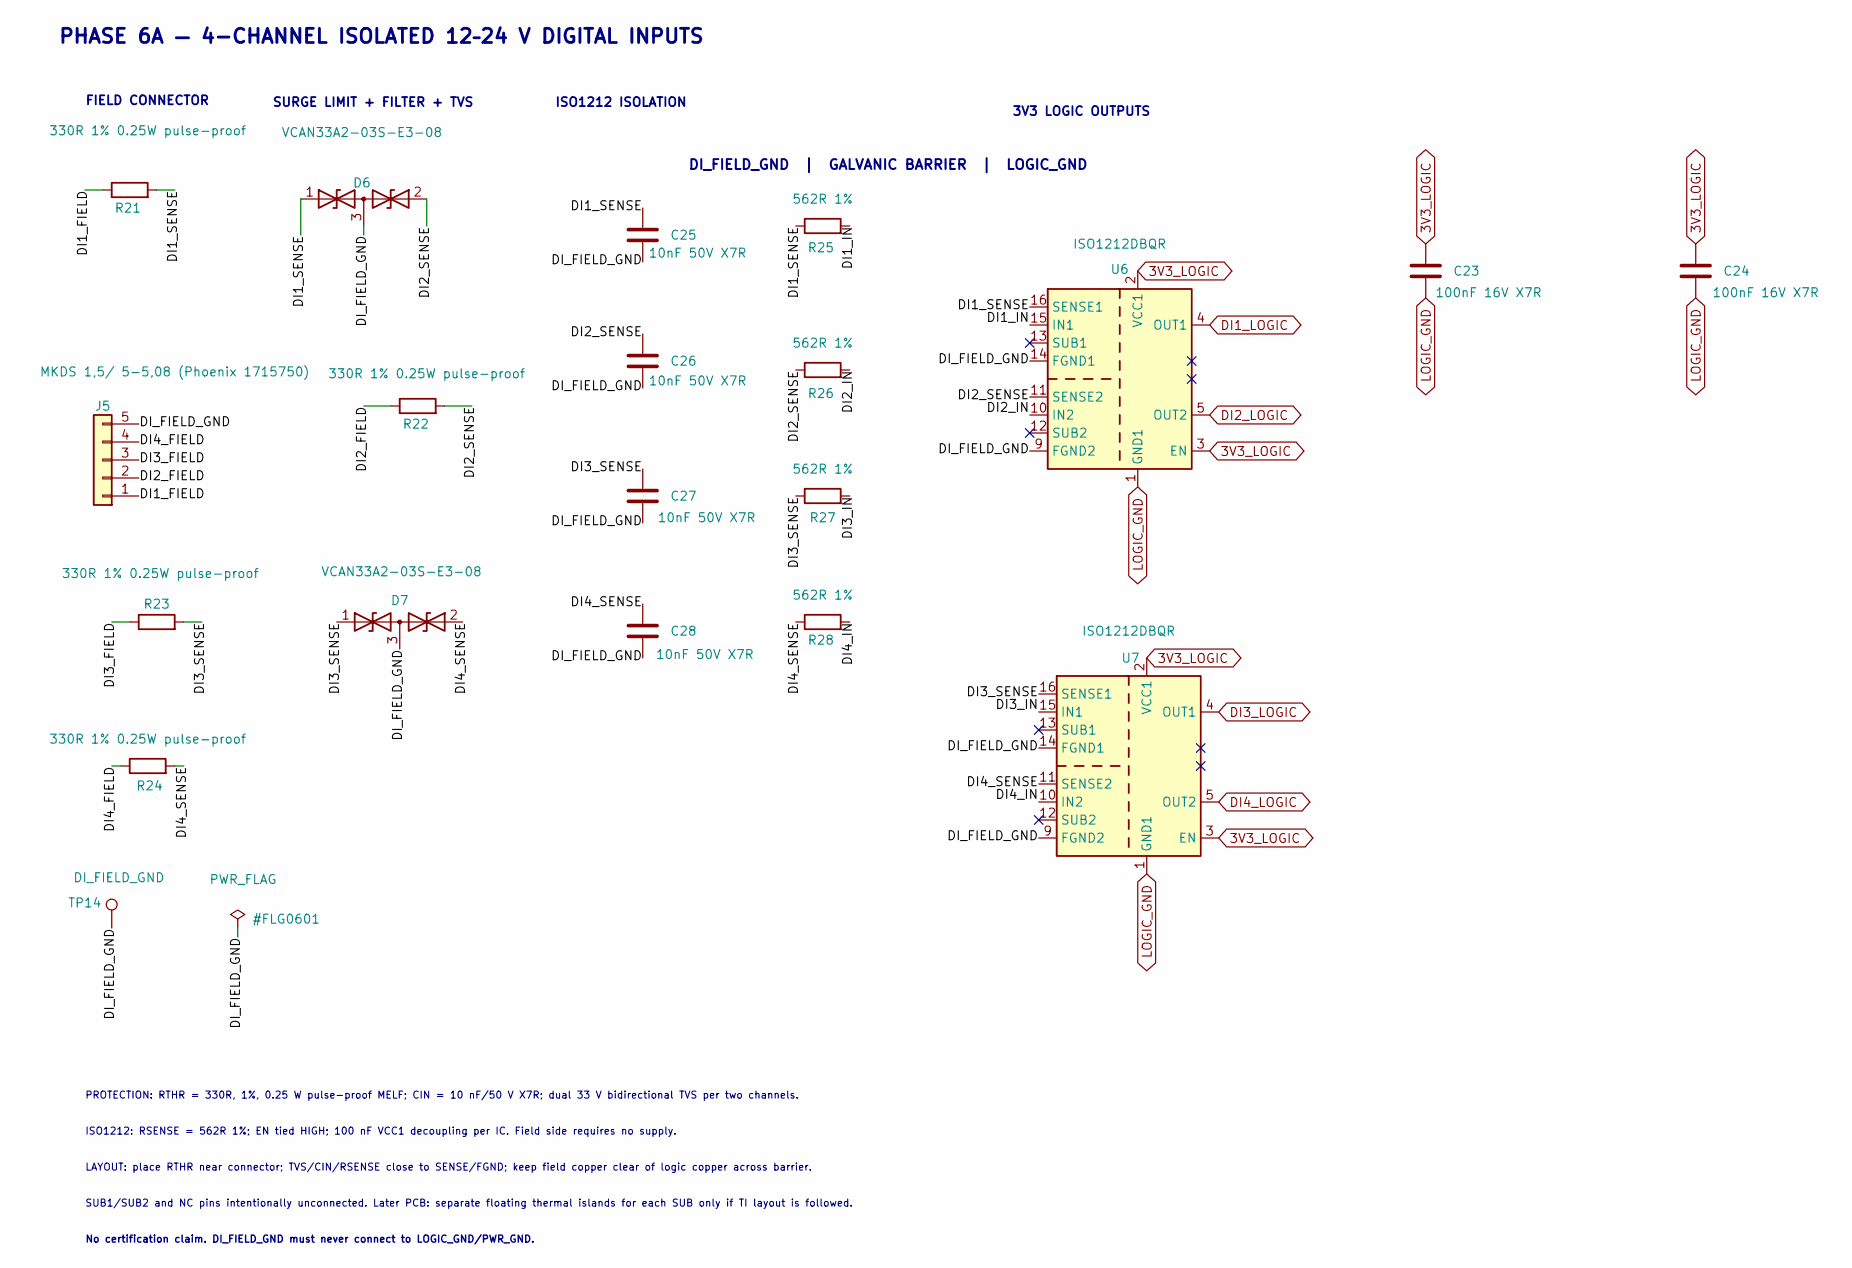
[picture p18: schematic digital_inputs_isolated.kicad_sch]

Parts:
C23, C24: 100nF 16V X7R; C_0603_1608Metric
C25, C26, C27, C28: 10nF 50V X7R; C_0603_1608Metric
D6, D7: VCAN33A2-03S-E3-08; SOT-23; MPN VCAN33A2-03S-E3-08
J5: MKDS 1,5/ 5-5,08 (Phoenix 1715750); TerminalBlock_Phoenix_MKDS-1,5-5-5.08_1x05_P5.08mm_Horizont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; MPN 1715750
R21, R22, R23, R24: 330R 1% 0.25W pulse-proof; R_MiniMELF_MMA-0204
R25, R26, R27, R28: 562R 1%; R_0603_1608Metric
TP14: DI_FIELD_GND; TestPoint_Pad_D1.0mm
U6, U7: ISO1212DBQR; SSOP-16_3.9x4.9mm_P0.635mm; MPN ISO1212DBQR

Connections:
3V3_LOGIC: C23.1, C24.1, U6.2 (VCC1), U6.3 (EN), U7.2 (VCC1), U7.3 (EN); also elsewhere on the board
/DIGITAL_INPUTS_ISOLATED/DI1_FIELD: J5.1, R21.1
/DIGITAL_INPUTS_ISOLATED/DI1_IN: R25.2, U6.15 (IN1)
/DIGITAL_INPUTS_ISOLATED/DI1_SENSE: C25.1, D6.1 (A1), R21.2, R25.1, U6.16 (SENSE1)
/DIGITAL_INPUTS_ISOLATED/DI2_FIELD: J5.2, R22.1
/DIGITAL_INPUTS_ISOLATED/DI2_IN: R26.2, U6.10 (IN2)
/DIGITAL_INPUTS_ISOLATED/DI2_SENSE: C26.1, D6.2 (A2), R22.2, R26.1, U6.11 (SENSE2)
/DIGITAL_INPUTS_ISOLATED/DI3_FIELD: J5.3, R23.1
/DIGITAL_INPUTS_ISOLATED/DI3_IN: R27.2, U7.15 (IN1)
/DIGITAL_INPUTS_ISOLATED/DI3_SENSE: C27.1, D7.1 (A1), R23.2, R27.1, U7.16 (SENSE1)
/DIGITAL_INPUTS_ISOLATED/DI4_FIELD: J5.4, R24.1
/DIGITAL_INPUTS_ISOLATED/DI4_IN: R28.2, U7.10 (IN2)
/DIGITAL_INPUTS_ISOLATED/DI4_SENSE: C28.1, D7.2 (A2), R24.2, R28.1, U7.11 (SENSE2)
/DIGITAL_INPUTS_ISOLATED/DI_FIELD_GND: C25.2, C26.2, C27.2, C28.2, D6.3 (common), D7.3 (common), J5.5, TP14.1, U6.9 (FGND2), U6.14 (FGND1), U7.9 (FGND2), U7.14 (FGND1)
DI1_LOGIC: U6.4 (OUT1); also elsewhere on the board
DI2_LOGIC: U6.5 (OUT2); also elsewhere on the board
DI3_LOGIC: U7.4 (OUT1); also elsewhere on the board
DI4_LOGIC: U7.5 (OUT2); also elsewhere on the board
LOGIC_GND: C23.2, C24.2, U6.1 (GND1), U6.8 (GND1), U7.1 (GND1), U7.8 (GND1); also elsewhere on the board

Notes on the sheet:
SURGE LIMIT + FILTER + TVS
3V3 LOGIC OUTPUTS
LAYOUT: place RTHR near connector; TVS/CIN/RSENSE close to SENSE/FGND; keep field copper clear of logic copper across barrier.
PROTECTION: RTHR = 330R, 1%, 0.25 W pulse-proof MELF; CIN = 10 nF/50 V X7R; dual 33 V bidirectional TVS per two channels.
DI_FIELD_GND | GALVANIC BARRIER | LOGIC_GND
ISO1212 ISOLATION
FIELD CONNECTOR
SUB1/SUB2 and NC pins intentionally unconnected. Later PCB: separate floating thermal islands for each SUB only if TI layout is followed.
PHASE 6A — 4-CHANNEL ISOLATED 12–24 V DIGITAL INPUTS
ISO1212: RSENSE = 562R 1%; EN tied HIGH; 100 nF VCC1 decoupling per IC. Field side requires no supply.
No certification claim. DI_FIELD_GND must never connect to LOGIC_GND/PWR_GND.
