deenqtt/project-test/hardware/kicad_mcp_test.kicad_pcb

## KiCad design hardware/kicad_mcp_test.kicad_pcb (continued)

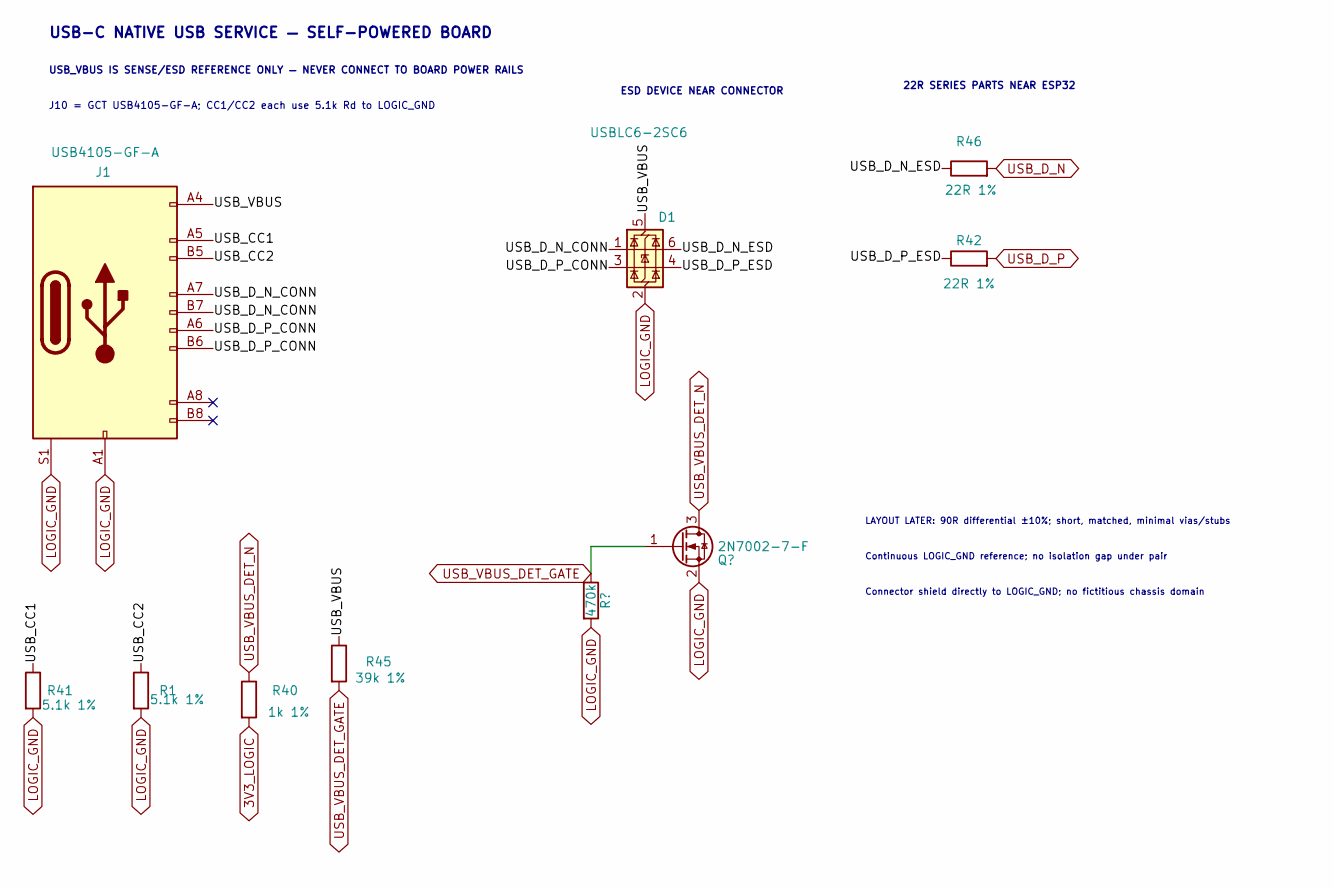
[picture p19: schematic usb_c.kicad_sch]

Parts:
D1: USBLC6-2SC6; SOT-23-6; MPN USBLC6-2SC6
J1: USB4105-GF-A; USB_C_Receptacle_GCT_USB4105-xx-A_16P_TopMnt_Horizontal; MPN USB4105-GF-A
R1, R41: 5.1k 1%; R_0603_1608Metric
R40: 1k 1%; R_0603_1608Metric
R42, R46: 22R 1%; R_0603_1608Metric
R45: 39k 1%; R_0603_1608Metric

Connections:
3V3_LOGIC: R40.2; also elsewhere on the board
/USB_C/USB_CC1: J1.A5 (CC1), R41.1
/USB_C/USB_CC2: J1.B5 (CC2), R1.1
/USB_C/USB_D_N_CONN: D1.1 (I/O1), J1.A7 (D-), J1.B7 (D-)
/USB_C/USB_D_N_ESD: D1.6 (I/O1), R46.1
/USB_C/USB_D_P_CONN: D1.3 (I/O2), J1.A6 (D+), J1.B6 (D+)
/USB_C/USB_D_P_ESD: D1.4 (I/O2), R42.1
/USB_C/USB_VBUS: D1.5 (VBUS), J1.A4 (VBUS), J1.A9 (VBUS), J1.B4 (VBUS), J1.B9 (VBUS), R45.1
LOGIC_GND: D1.2 (GND), J1.A1 (GND), J1.A12 (GND), J1.B1 (GND), J1.B12 (GND), J1.S1 (SHIELD), R1.2, R41.2; also elsewhere on the board
USB_D_N: R46.2; also elsewhere on the board
USB_D_P: R42.2; also elsewhere on the board
USB_VBUS_DET_GATE: R45.2; also elsewhere on the board
USB_VBUS_DET_N: R40.1; also elsewhere on the board

Notes on the sheet:
J10 = GCT USB4105-GF-A; CC1/CC2 each use 5.1k Rd to LOGIC_GND
LAYOUT LATER: 90R differential ±10%; short, matched, minimal vias/stubs
22R SERIES PARTS NEAR ESP32
Connector shield directly to LOGIC_GND; no fictitious chassis domain
ESD DEVICE NEAR CONNECTOR
Continuous LOGIC_GND reference; no isolation gap under pair
USB_VBUS IS SENSE/ESD REFERENCE ONLY — NEVER CONNECT TO BOARD POWER RAILS
USB-C NATIVE USB SERVICE — SELF-POWERED BOARD

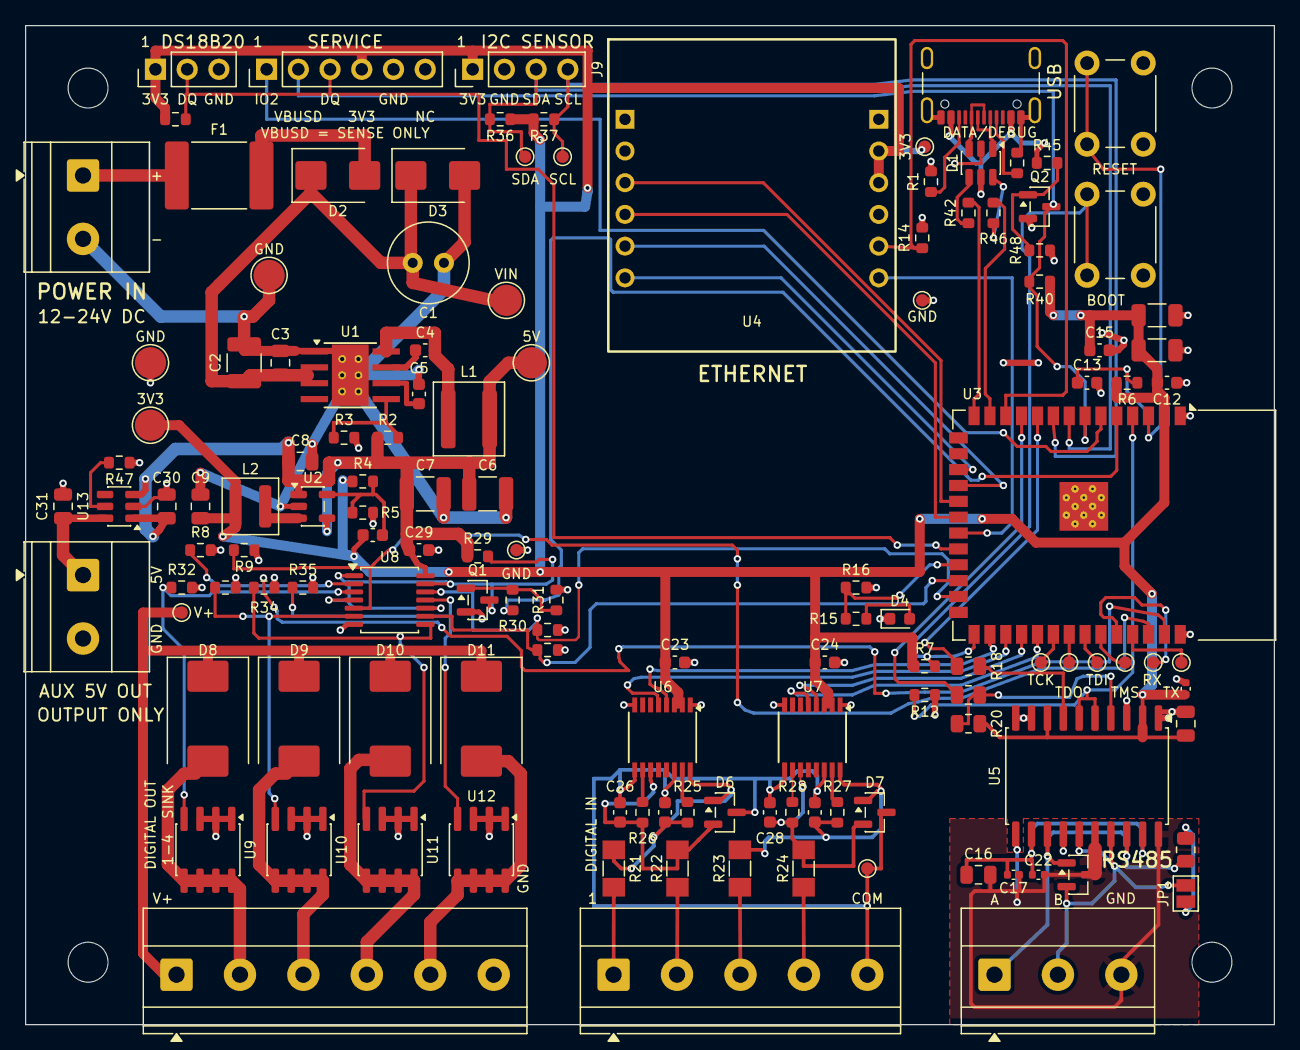
[picture p20: board hardware/kicad_mcp_test.kicad_pcb from above]

Board: 2 copper layers, 100.0 x 80.0 mm, 136 parts (0 on the bottom side), 88 nets.

Other parts of the board:
H1, H2, H3, H4: MountingHole_3.2mm_M3
Q2: 2N7002-7-F; SOT-23
R48: 470k; R_0603_1608Metric

Their connections:
LOGIC_GND: Q2.2, R48.2; also elsewhere on the board
USB_VBUS_DET_GATE: Q2.1, R48.1; also elsewhere on the board
USB_VBUS_DET_N: Q2.3; also elsewhere on the board
